peter890331/PS2-Wireless-Remote-Control-Teachable-Robotic-Arm/README.md

### PS2 無線遙控教導式機械手臂
### PS2-Wireless-Remote-Control-Teachable-Robotic-Arm
---
> A graduation project in high school

- Youtube：https://youtu.be/B3R5VX4Qshs    

壹、 摘要    
 PS2 無線遙控教導式機械手臂，透過流暢的自動學習系統，提升機械手臂流程修改上的效率，本團隊利用整合 PS2 無線遙控模組與 LCD 顯示器，做出簡單的人機控制介面，PS2 控制器用來操控機械手臂的所有動作，LCD 則用以顯示動作資訊，使用者便能夠更簡單地對機械手臂進行操控與教導，讓功能完善的自組機械手臂自動化做出任何使用者教導的動作流程，令其持續工作，當然也能隨時教導新的動作流程。而使用者也能夠在設定流程時選擇自動流程所需的次數， 模擬工廠自動設備的工作要求。    

貳、 研究動機    
在現代的製造業裡，以機器取代人力已經成為主流。而機械手臂的應用也是其大宗。機械手臂是具有模仿人類手臂功能並可完成各種作業的自動控制設備，且能一機多用，不限於單一種工作。另外，可程式化的控制也可以減少純人工的失誤。 但是若純粹只以固定的程式動作一套流程並不完全便利，想要進行其他動作的話就需要編寫新的整套程式。於是本團隊便想以人為的一次操作來對機器進行教導，製造出可教導式的機械手臂，透過單次的學習來使機器能夠無限反覆進行學習到的動作流程，流程完全仿照使用者設定操作的樣子，且能夠隨時重新教導新的動作，省下編寫新的程式所需的耗費。而方便的遙控操作與顯示介面也能讓使用者在對機器進行教導時更容易上手。    

#發燒影片井1 #大安高工 #專題 #高中職 #全國專題製作競賽 #ARDUINO #機械手臂  
  
Awards：  
1. Honorable Mention in the department  
    

2. Merit Award in 全國高級中等學校專業群科107年專題製作競賽  
    
    
