peter890331/PS2-Wireless-Remote-Control-Teachable-Robotic-Arm/(commit log)

2023-06-18 20180510.ino
    稍微整理過註解
2023-06-18 PS2-Wireless-Remote-Control-Teachable-Robotic-Arm
    專題說明書
